Jaycar-Electronics/Camping-Power-Meter/images/plug.jpg

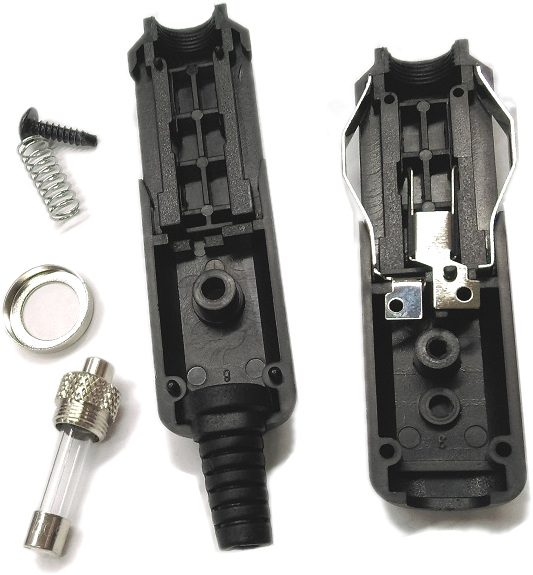
images/plug.jpg
