Jaycar-Electronics/Camping-Power-Meter/(commit log)

2019-01-08 forgot dumb arduino things
2019-02-12 updated images to reflrect resistor change
